aakash3141/ieeewhackaclanker/IEEEArcade/Project Information/Scoreboard Display/FrontofDisplay.png

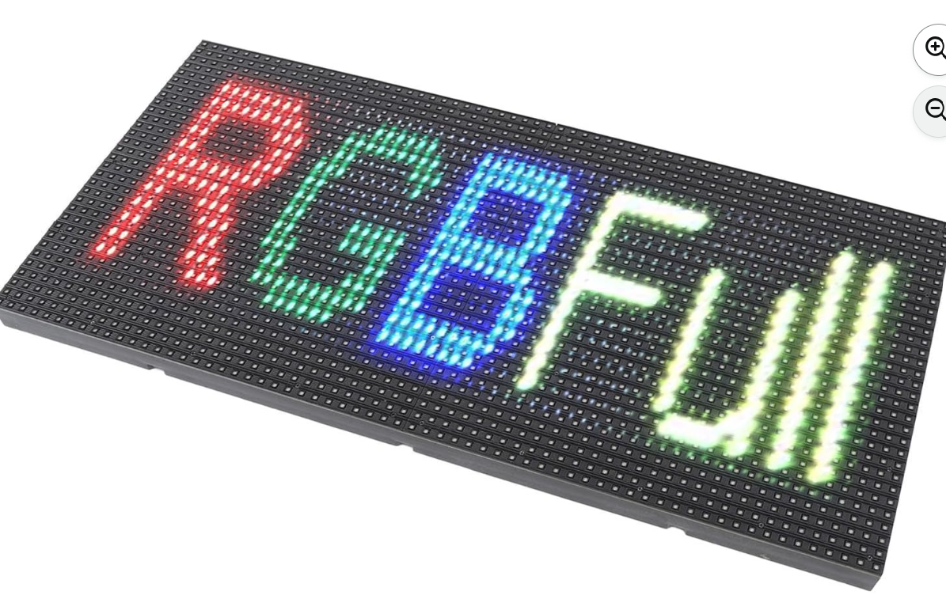
IEEEArcade/Project Information/Scoreboard Display/FrontofDisplay.png
