aakash3141/ieeewhackaclanker/IEEEArcade/Project Information/Scoreboard Display/BackofDisplay.png

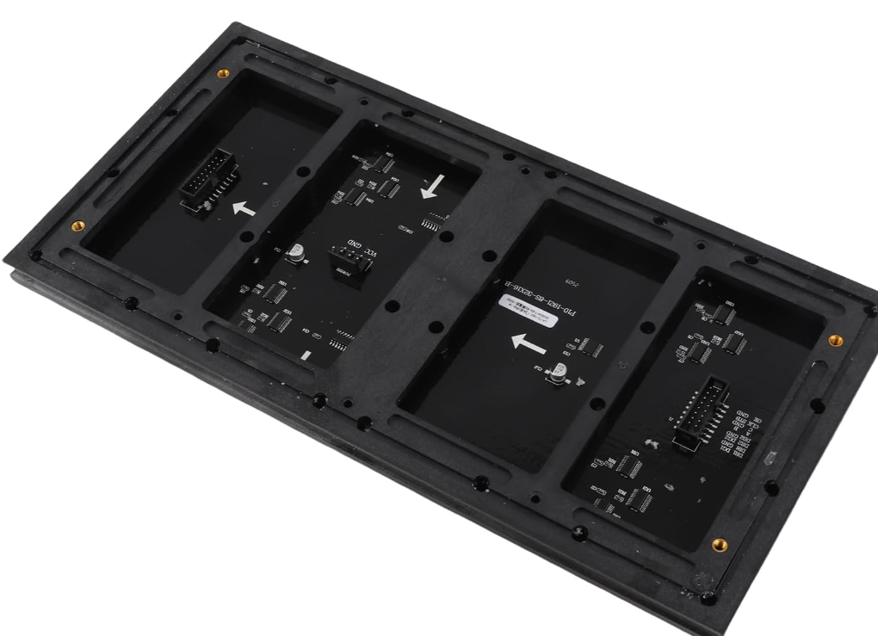
IEEEArcade/Project Information/Scoreboard Display/BackofDisplay.png
