aakash3141/ieeewhackaclanker/IEEEArcade/Project Information/Scoreboard Display/DisplayConnections1.png

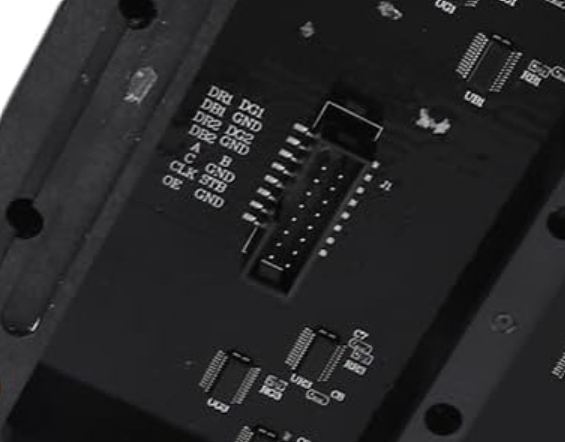
IEEEArcade/Project Information/Scoreboard Display/DisplayConnections1.png
