aakash3141/ieeewhackaclanker/IEEEArcade/Project Information/Scoreboard Display/DisplayConnections2.png

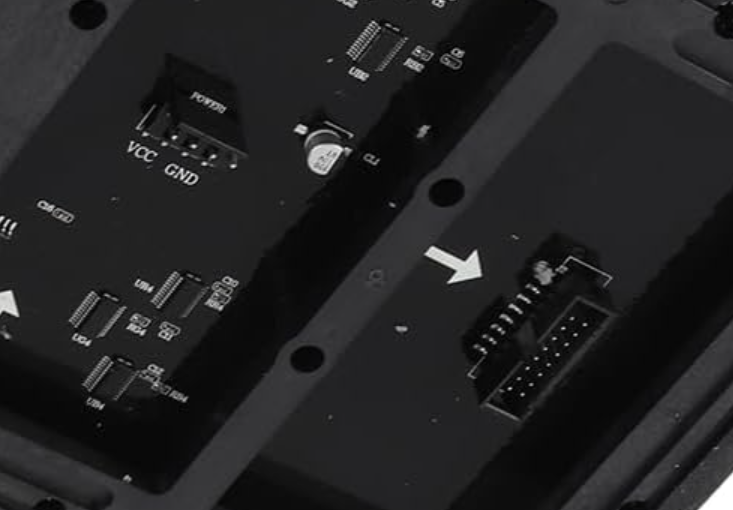
IEEEArcade/Project Information/Scoreboard Display/DisplayConnections2.png
