aakash3141/ieeewhackaclanker/IEEEArcade/BOM/26-27 Project BOM.xlsx

Bill of Materials
What we need: | Do we have it? | Part Number | Datasheet | Description | Quantity | Price
Power Converter | yes |  |  | 120VAC to 12DC 60W |  | 0
Buck Converter |  | TPS54202HDDCR | https://www.ti.com/lit/ds/symlink/tps54202h.pdf?HQS=dis-dk-null-digikeymode-dsf-pf-null-wwe&ts=1792712018270 | 12DC to 5VDC
30 Arcade Light Up Push Buttons |  |  | https://www.adafruit.com/product/1194
30 MOSFETS |  |  | https://www.aosmd.com/res/datasheets/AO3400A.pdf | Low threshold voltage, 30Vds max
Display |  |  | https://www.amazon.com/Alomejor-Scrolling-Enhanced-Lifespan-Restaurants/dp/B0G35QMCXN | P10
Small Arcade Push Buttons |  |  | https://www.amazon.com/EG-STARTS-Arcade-Buttons-Multicade/dp/B01M0XPWGG?s=toys-and-games
I/O Expander |  | MCP23017T-E/SO | https://ww1.microchip.com/downloads/aemDocuments/documents/APID/ProductDocuments/DataSheets/MCP23017-Data-Sheet-DS20001952.pdf
EEPROM |  | 24LC256-I/SN | https://ww1.microchip.com/downloads/aemDocuments/documents/MPD/ProductDocuments/DataSheets/24AA256-24LC256-24FC256-256K-I2C-Serial-EEPROM-DS20001203.pdf
Wire
