aakash3141/ieeewhackaclanker/IEEEArcade/IEEEArcade.kicad_pcb

## KiCad design IEEEArcade/IEEEArcade.kicad_pcb (2026-11-10)

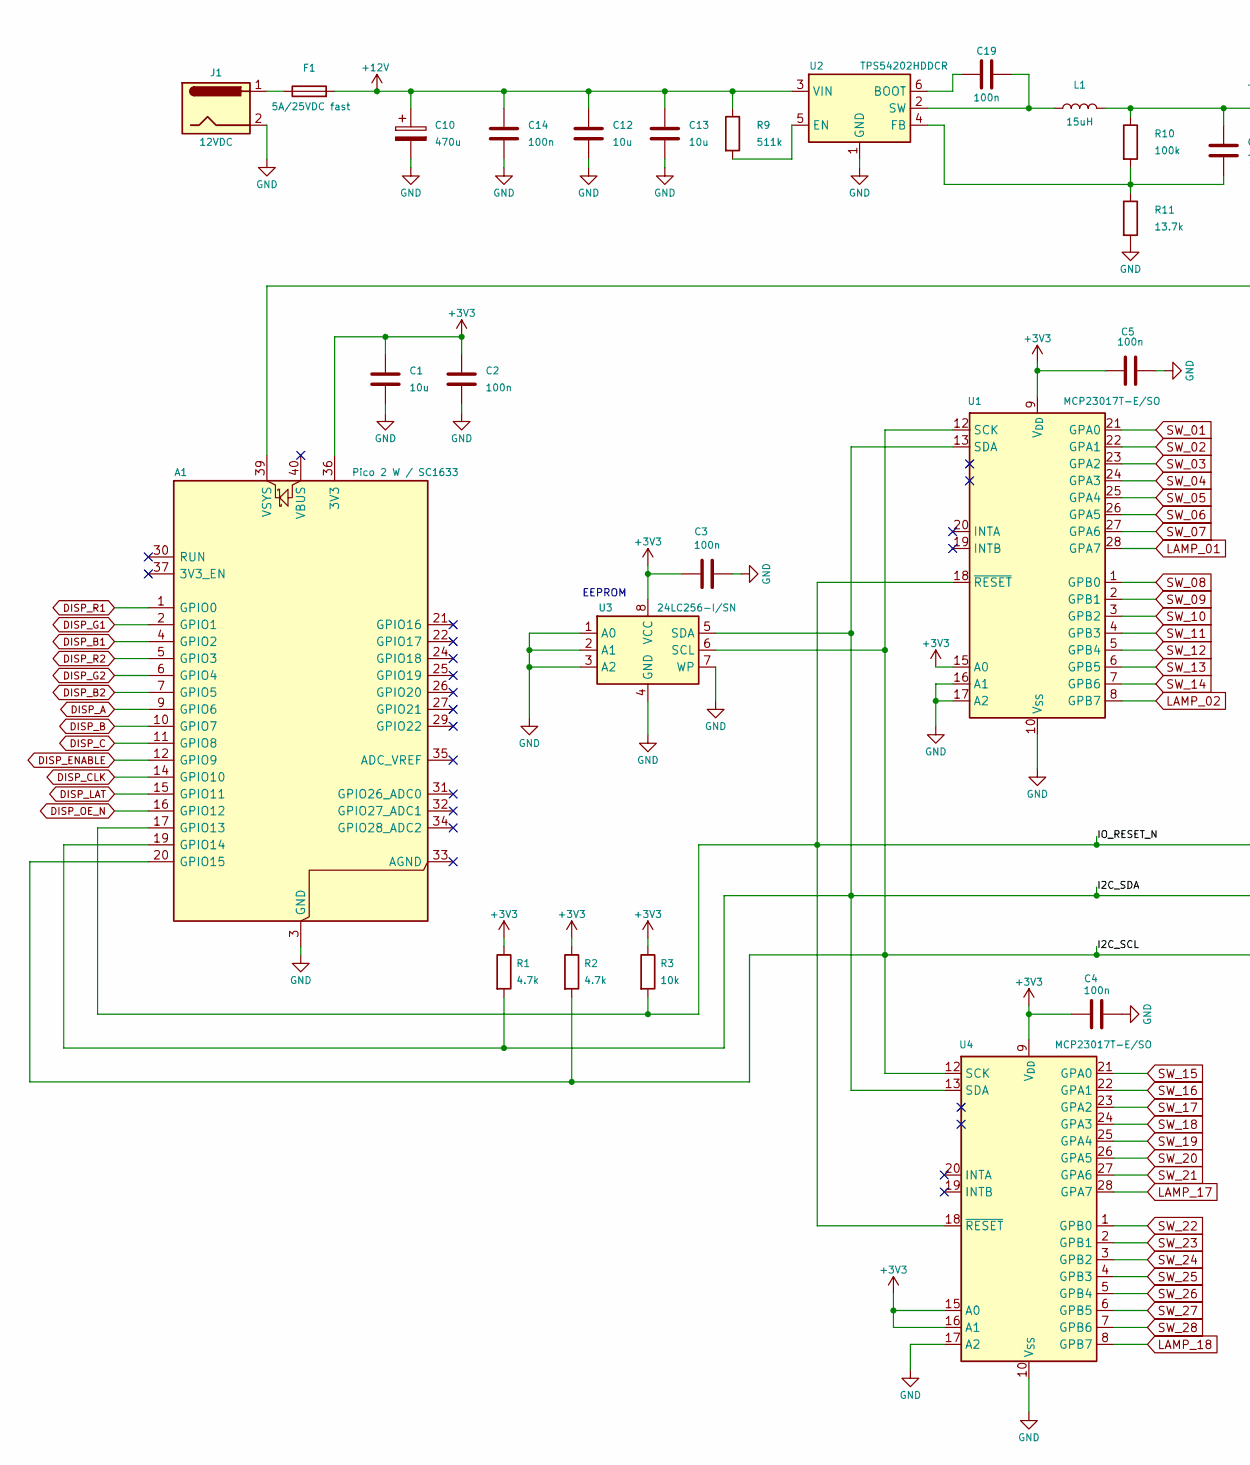
[picture p7: schematic IEEEArcade.kicad_sch, IEEE Arcade, part in row 1, column 1]

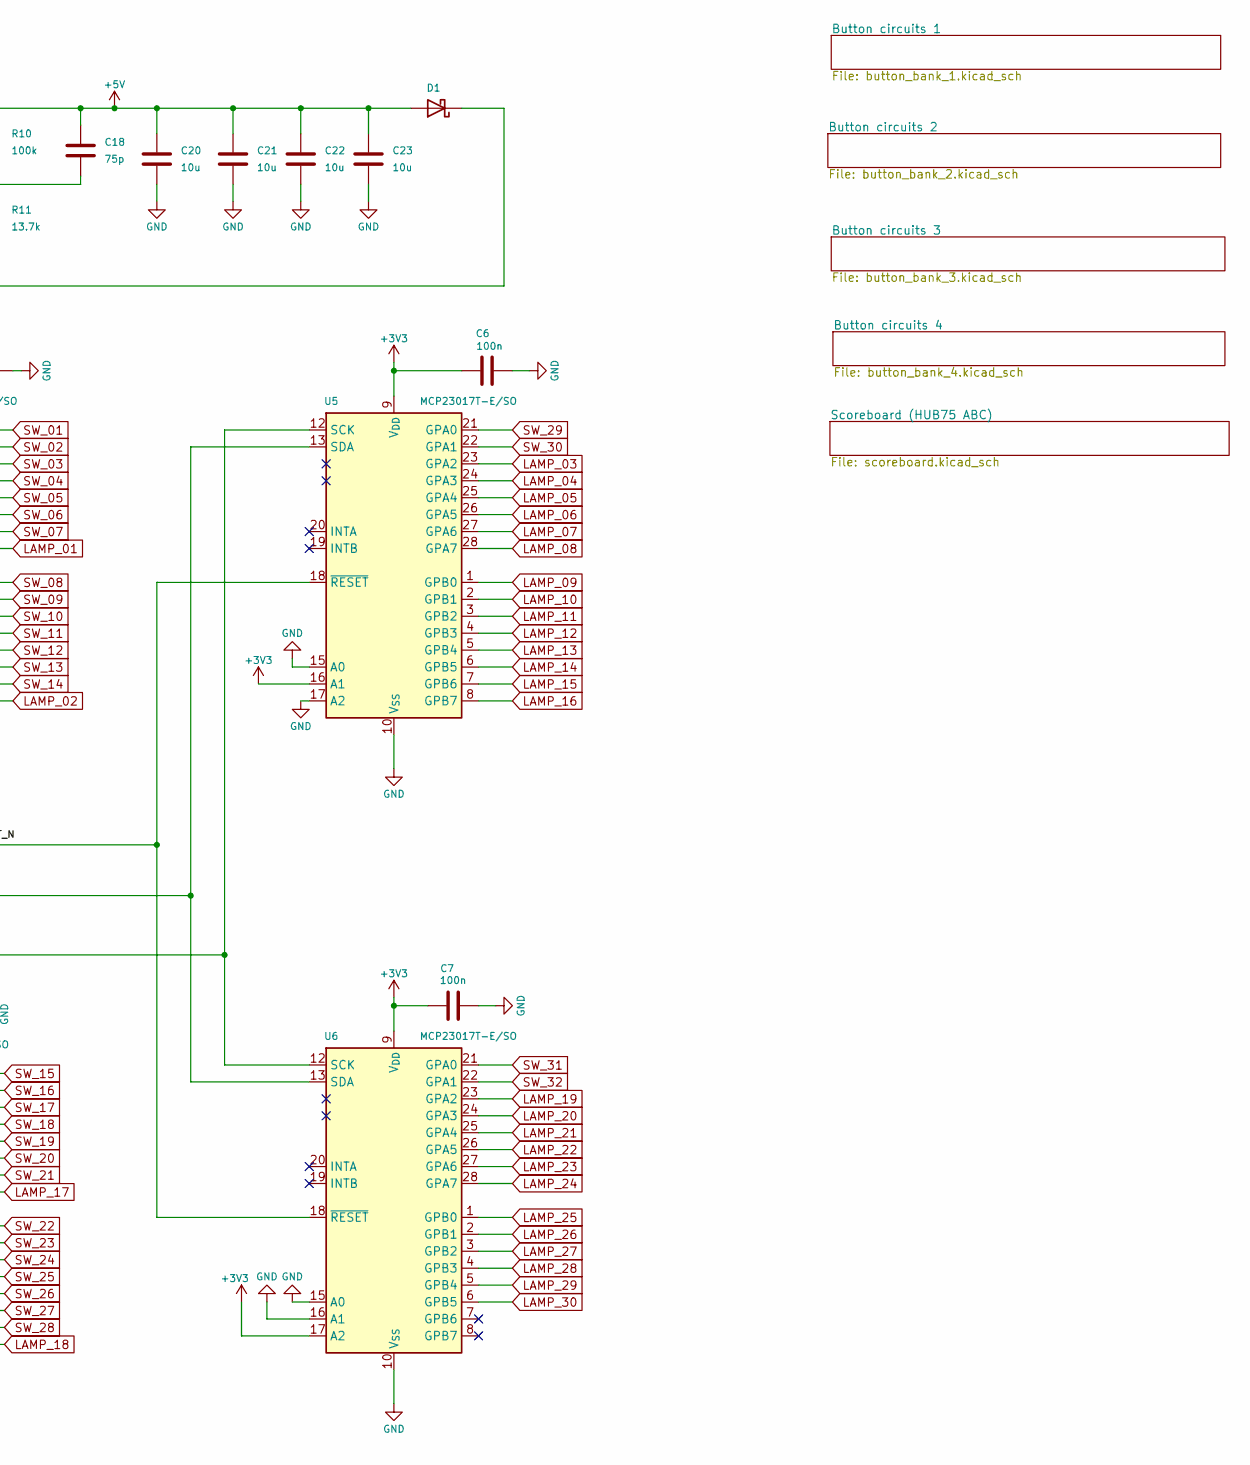
[picture p8: schematic IEEEArcade.kicad_sch, IEEE Arcade, part in row 1, column 2]

Parts:
A1: Pico 2 W / SC1633; RaspberryPi_Pico_W_SMD_HandSolder; MPN SC1633; DigiKey 2648-SC1633CT-ND
C1, C12, C13, C20, C21, C22, C23: 10u; C_1206_3216Metric_Pad1.33x1.80mm_HandSolder; MPN C1206C106K3RACTU; DigiKey 399-C1206C106K3RACTUCT-ND
C2, C3, C4, C5, C6, C7, C14, C19: 100n; C_1206_3216Metric_Pad1.33x1.80mm_HandSolder; MPN C1206C104K5RACTU; DigiKey 399-C1206C104K5RACTUCT-ND
C10: 470u; CP_Radial_D10.0mm_P5.00mm; MPN EEU-FR1E471; DigiKey P14419-ND
C18: 75p; C_1206_3216Metric_Pad1.33x1.80mm_HandSolder; MPN C1206C750J5GACTU; DigiKey 399-14710-1-ND
D1: SS14 / VSYS OR-ing; D_SMA; MPN SS14-E3/61T; DigiKey SS14-E3/61TGICT-ND
F1: 5A/25VDC fast; Fuseholder_Littelfuse_Nano2_154x; MPN 0154005.DR; DigiKey F1228CT-ND
J1: 12VDC; BarrelJack_CUI_PJ-063AH_Horizontal; MPN PJ-063AH; DigiKey CP-063AH-ND
L1: 15uH; L_Wurth_7447714150; MPN 7447714150; DigiKey 732-2990-1-ND
R1, R2: 4.7k; R_1206_3216Metric_Pad1.30x1.75mm_HandSolder; MPN RC1206FR-074K7L; DigiKey 311-4.70KFRCT-ND
R3: 10k; R_1206_3216Metric_Pad1.30x1.75mm_HandSolder; MPN RC1206FR-0710KL; DigiKey 311-10.0KFRCT-ND
R9: 511k; R_1206_3216Metric_Pad1.30x1.75mm_HandSolder; MPN RC1206FR-07511KL; DigiKey 311-511KFRCT-ND
R10: 100k; R_1206_3216Metric_Pad1.30x1.75mm_HandSolder; MPN RC1206FR-07100KL; DigiKey 311-100KFRCT-ND
R11: 13.7k; R_1206_3216Metric_Pad1.30x1.75mm_HandSolder; MPN RC1206FR-0713K7L; DigiKey 311-13.7KFRCT-ND
U1, U4, U5, U6: MCP23017T-E/SO; SOIC-28W_7.5x17.9mm_P1.27mm; MPN MCP23017T-E/SO; DigiKey MCP23017T-E/SOCT-ND
U2: TPS54202HDDCR; SOT-23-6_Handsoldering; MPN TPS54202HDDCR; DigiKey 296-44396-1-ND
U3: 24LC256-I/SN; SOIC-8_3.9x4.9mm_P1.27mm; MPN 24LC256-I/SN; DigiKey 24LC256-I/SN-ND

Connections:
+3V3: A1.36 (3V3), C1.1, C2.1, C3.1, C4.1, C5.1, C6.1, C7.1, R1.1, R2.1, R3.1, U1.9 (V_{DD}), U1.15 (A0), U3.8 (VCC), U4.9 (V_{DD}), U4.15 (A0), U4.16 (A1), U5.9 (V_{DD}), U5.16 (A1), U6.9 (V_{DD}), U6.17 (A2); also elsewhere on the board
+5V: C18.1, C20.1, C21.1, C22.1, C23.1, D1.2 (A), L1.2, R10.1
+12V: C10.1, C12.1, C13.1, C14.1, F1.2, R9.1, U2.3 (VIN); also elsewhere on the board
/I2C_SCL: A1.20 (GPIO15), R2.2, U1.12 (SCK), U3.6 (SCL), U4.12 (SCK), U5.12 (SCK), U6.12 (SCK)
/I2C_SDA: A1.19 (GPIO14), R1.2, U1.13 (SDA), U3.5 (SDA), U4.13 (SDA), U5.13 (SDA), U6.13 (SDA)
/IO_RESET_N: A1.17 (GPIO13), R3.2, U1.18 (~RESET), U4.18 (~RESET), U5.18 (~RESET), U6.18 (~RESET)
DISP_A: A1.9 (GPIO6); also elsewhere on the board
DISP_B: A1.10 (GPIO7); also elsewhere on the board
DISP_B1: A1.4 (GPIO2); also elsewhere on the board
DISP_B2: A1.7 (GPIO5); also elsewhere on the board
DISP_C: A1.11 (GPIO8); also elsewhere on the board
DISP_CLK: A1.14 (GPIO10); also elsewhere on the board
DISP_ENABLE: A1.12 (GPIO9); also elsewhere on the board
DISP_G1: A1.2 (GPIO1)
DISP_G2: A1.6 (GPIO4); also elsewhere on the board
DISP_LAT: A1.15 (GPIO11); also elsewhere on the board
DISP_OE_N: A1.16 (GPIO12); also elsewhere on the board
DISP_R1: A1.1 (GPIO0); also elsewhere on the board
DISP_R2: A1.5 (GPIO3); also elsewhere on the board
GND: A1.3 (GND), A1.8 (GND), A1.13 (GND), A1.18 (GND), A1.23 (GND), A1.28 (GND), A1.38 (GND), C1.2, C2.2, C3.2, C4.2, C5.2, C6.2, C7.2, C10.2, C12.2, C13.2, C14.2, C20.2, C21.2, C22.2, C23.2, J1.2, R11.2, U1.10 (V_{SS}), U1.16 (A1), U1.17 (A2), U2.1 (GND), U3.1 (A0), U3.2 (A1), U3.3 (A2), U3.4 (GND), U3.7 (WP), U4.10 (V_{SS}), U4.17 (A2), U5.10 (V_{SS}), U5.15 (A0), U5.17 (A2), U6.10 (V_{SS}), U6.15 (A0), U6.16 (A1); also elsewhere on the board
LAMP_01: U1.28 (GPA7); also elsewhere on the board
LAMP_02: U1.8 (GPB7); also elsewhere on the board
LAMP_03: U5.23 (GPA2); also elsewhere on the board
LAMP_04: U5.24 (GPA3); also elsewhere on the board
LAMP_05: U5.25 (GPA4); also elsewhere on the board
LAMP_06: U5.26 (GPA5); also elsewhere on the board
LAMP_07: U5.27 (GPA6); also elsewhere on the board
LAMP_08: U5.28 (GPA7); also elsewhere on the board
LAMP_09: U5.1 (GPB0); also elsewhere on the board
LAMP_10: U5.2 (GPB1); also elsewhere on the board
LAMP_11: U5.3 (GPB2); also elsewhere on the board
LAMP_12: U5.4 (GPB3); also elsewhere on the board
LAMP_13: U5.5 (GPB4); also elsewhere on the board
LAMP_14: U5.6 (GPB5); also elsewhere on the board
LAMP_15: U5.7 (GPB6); also elsewhere on the board
LAMP_16: U5.8 (GPB7); also elsewhere on the board
LAMP_17: U4.28 (GPA7); also elsewhere on the board
LAMP_18: U4.8 (GPB7); also elsewhere on the board
LAMP_19: U6.23 (GPA2); also elsewhere on the board
LAMP_20: U6.24 (GPA3); also elsewhere on the board
LAMP_21: U6.25 (GPA4); also elsewhere on the board
LAMP_22: U6.26 (GPA5); also elsewhere on the board
LAMP_23: U6.27 (GPA6); also elsewhere on the board
LAMP_24: U6.28 (GPA7); also elsewhere on the board
LAMP_25: U6.1 (GPB0); also elsewhere on the board
LAMP_26: U6.2 (GPB1); also elsewhere on the board
LAMP_27: U6.3 (GPB2); also elsewhere on the board
LAMP_28: U6.4 (GPB3); also elsewhere on the board
LAMP_29: U6.5 (GPB4); also elsewhere on the board
LAMP_30: U6.6 (GPB5); also elsewhere on the board
unnamed: A1.39 (VSYS), D1.1 (K)
unnamed: F1.1, J1.1
unnamed: C19.1, U2.6 (BOOT)
unnamed: R9.2, U2.5 (EN)
unnamed: C18.2, R10.2, R11.1, U2.4 (FB)
unnamed: C19.2, L1.1, U2.2 (SW)
SW_01: U1.21 (GPA0); also elsewhere on the board
SW_02: U1.22 (GPA1); also elsewhere on the board
SW_03: U1.23 (GPA2); also elsewhere on the board
SW_04: U1.24 (GPA3); also elsewhere on the board
SW_05: U1.25 (GPA4); also elsewhere on the board
SW_06: U1.26 (GPA5); also elsewhere on the board
SW_07: U1.27 (GPA6); also elsewhere on the board
SW_08: U1.1 (GPB0); also elsewhere on the board
SW_09: U1.2 (GPB1); also elsewhere on the board
SW_10: U1.3 (GPB2); also elsewhere on the board
SW_11: U1.4 (GPB3); also elsewhere on the board
SW_12: U1.5 (GPB4); also elsewhere on the board
SW_13: U1.6 (GPB5); also elsewhere on the board
SW_14: U1.7 (GPB6); also elsewhere on the board
SW_15: U4.21 (GPA0); also elsewhere on the board
SW_16: U4.22 (GPA1); also elsewhere on the board
SW_17: U4.23 (GPA2); also elsewhere on the board
SW_18: U4.24 (GPA3); also elsewhere on the board
SW_19: U4.25 (GPA4); also elsewhere on the board
SW_20: U4.26 (GPA5); also elsewhere on the board
SW_21: U4.27 (GPA6); also elsewhere on the board
SW_22: U4.1 (GPB0); also elsewhere on the board
SW_23: U4.2 (GPB1); also elsewhere on the board
SW_24: U4.3 (GPB2); also elsewhere on the board
SW_25: U4.4 (GPB3); also elsewhere on the board
SW_26: U4.5 (GPB4); also elsewhere on the board
SW_27: U4.6 (GPB5); also elsewhere on the board
SW_28: U4.7 (GPB6); also elsewhere on the board
SW_29: U5.21 (GPA0); also elsewhere on the board
SW_30: U5.22 (GPA1); also elsewhere on the board
SW_31: U6.21 (GPA0); also elsewhere on the board
SW_32: U6.22 (GPA1); also elsewhere on the board

Notes on the sheet:
EEPROM

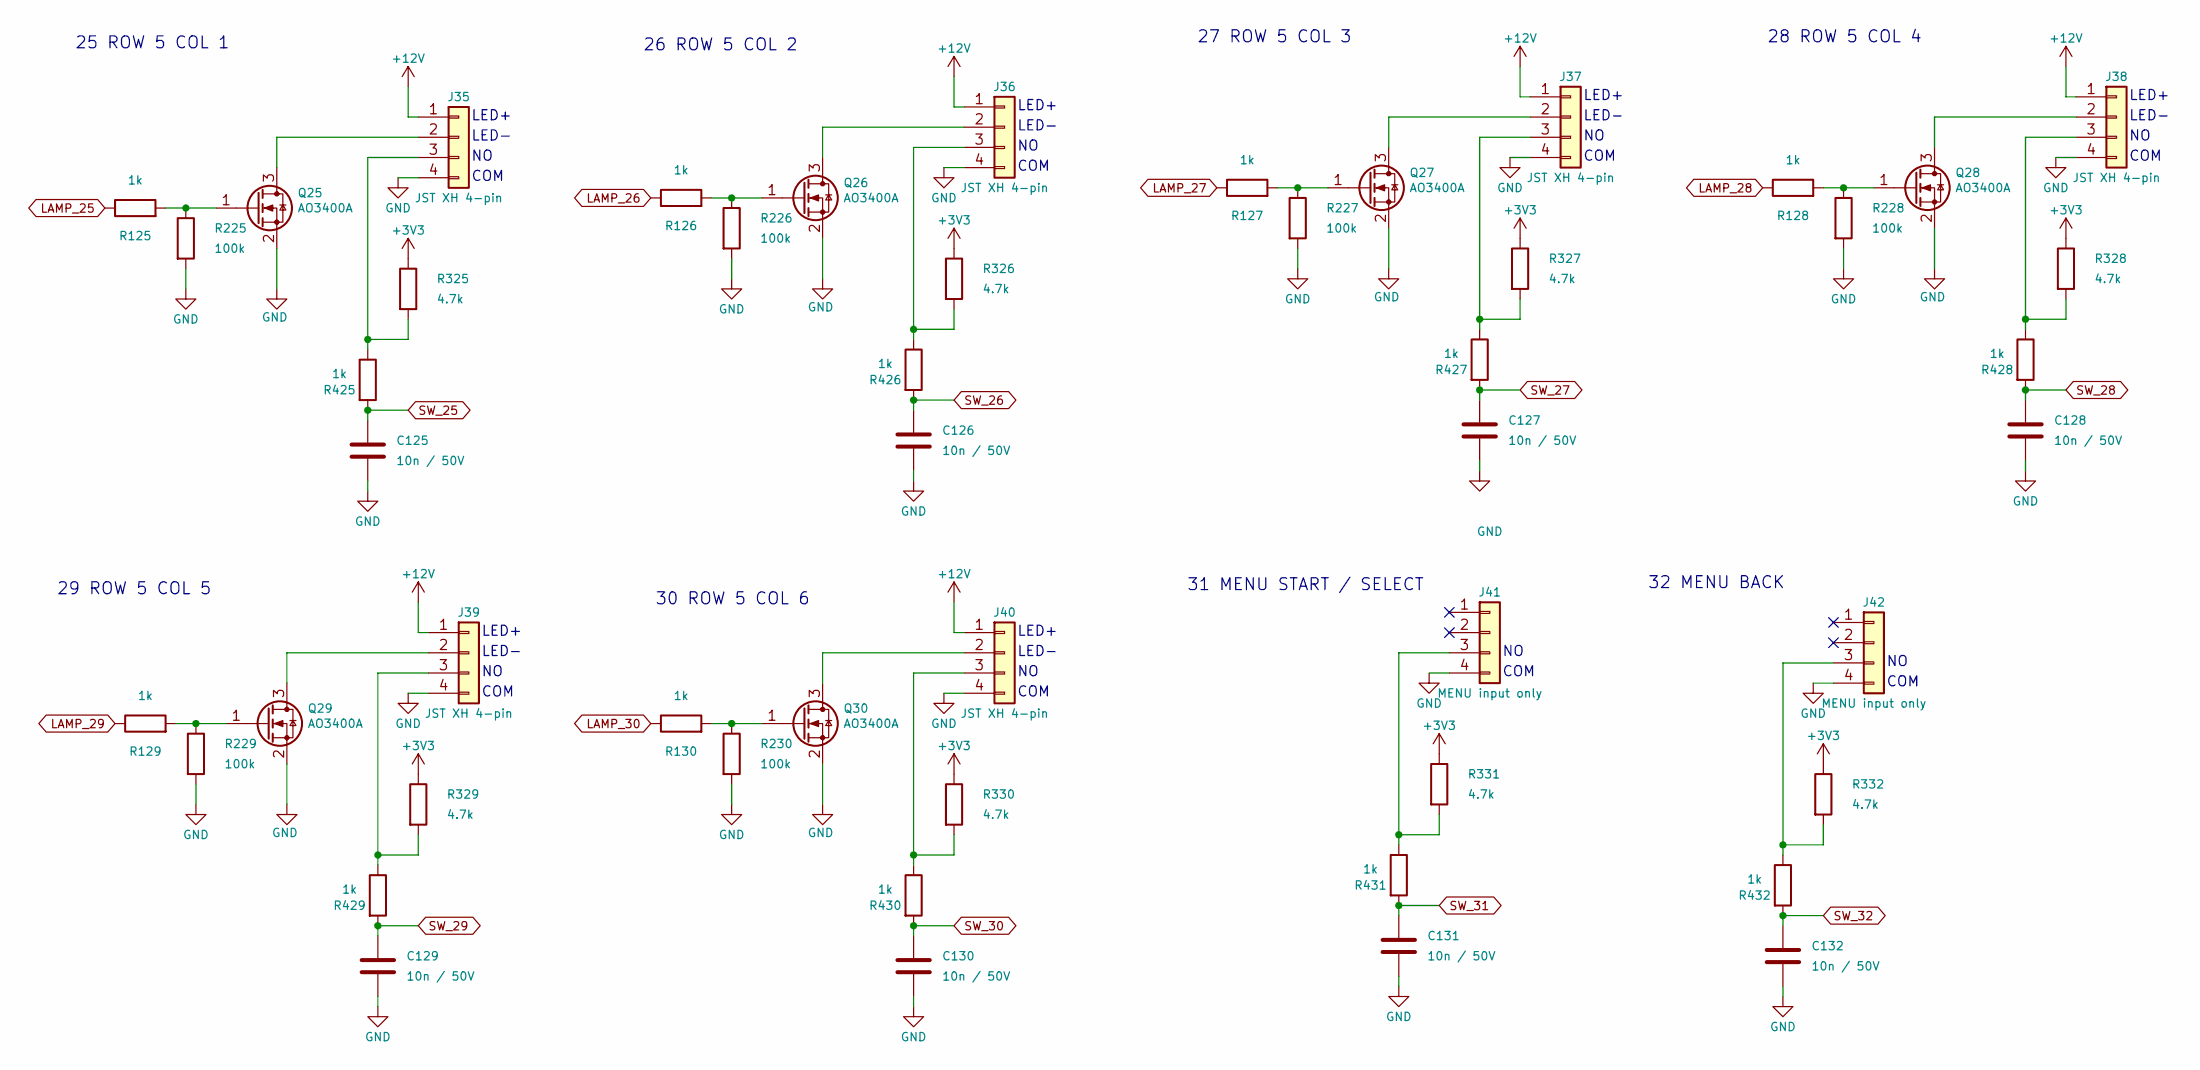
[picture p9: schematic button_bank_4.kicad_sch, Button harness: Buttons 25-32]

Parts:
C125, C126, C127, C128, C129, C130, C131, C132: 10n / 50V; C_1206_3216Metric_Pad1.33x1.80mm_HandSolder; MPN C1206C103K5RACTU; DigiKey 399-C1206C103K5RACTUCT-ND
J35, J36, J37, J38, J39, J40: JST XH 4-pin; JST_XH_B4B-XH-A_1x04_P2.50mm_Vertical; MPN B4B-XH-A; DigiKey 455-B4B-XH-A-ND
J41, J42: MENU input only; JST_XH_B4B-XH-A_1x04_P2.50mm_Vertical; MPN B4B-XH-A; DigiKey 455-B4B-XH-A-ND
Q25, Q26, Q27, Q28, Q29, Q30: AO3400A; SOT-23; MPN AO3400A; DigiKey 785-1000-1-ND
R125, R126, R127, R128, R129, R130, R425, R426, R427, R428, R429, R430, R431, R432: 1k; R_1206_3216Metric_Pad1.30x1.75mm_HandSolder; MPN RC1206FR-071KL; DigiKey 311-1.00KFRCT-ND
R225, R226, R227, R228, R229, R230: 100k; R_1206_3216Metric_Pad1.30x1.75mm_HandSolder; MPN RC1206FR-07100KL; DigiKey 311-100KFRCT-ND
R325, R326, R327, R328, R329, R330, R331, R332: 4.7k; R_1206_3216Metric_Pad1.30x1.75mm_HandSolder; MPN RC1206FR-074K7L; DigiKey 311-4.70KFRCT-ND

Connections:
+3V3: R325.1, R326.1, R327.1, R328.1, R329.1, R330.1, R331.1, R332.1; also elsewhere on the board
+12V: J35.1, J36.1, J37.1, J38.1, J39.1, J40.1; also elsewhere on the board
GND: C125.2, C126.2, C127.2, C128.2, C129.2, C130.2, C131.2, C132.2, J35.4, J36.4, J37.4, J38.4, J39.4, J40.4, J41.4, J42.4, Q25.2 (S), Q26.2 (S), Q27.2 (S), Q28.2 (S), Q29.2 (S), Q30.2 (S), R225.2, R226.2, R227.2, R228.2, R229.2, R230.2; also elsewhere on the board
LAMP_25: R125.1; also elsewhere on the board
LAMP_26: R126.1; also elsewhere on the board
LAMP_27: R127.1; also elsewhere on the board
LAMP_28: R128.1; also elsewhere on the board
LAMP_29: R129.1; also elsewhere on the board
LAMP_30: R130.1; also elsewhere on the board
unnamed: J35.2, Q25.3 (D)
unnamed: J35.3, R325.2, R425.1
unnamed: J36.2, Q26.3 (D)
unnamed: J36.3, R326.2, R426.1
unnamed: J37.2, Q27.3 (D)
unnamed: J37.3, R327.2, R427.1
unnamed: J38.2, Q28.3 (D)
unnamed: J38.3, R328.2, R428.1
unnamed: J39.2, Q29.3 (D)
unnamed: J39.3, R329.2, R429.1
unnamed: J40.2, Q30.3 (D)
unnamed: J40.3, R330.2, R430.1
unnamed: J41.3, R331.2, R431.1
unnamed: J42.3, R332.2, R432.1
unnamed: Q25.1 (G), R125.2, R225.1
unnamed: Q26.1 (G), R126.2, R226.1
unnamed: Q27.1 (G), R127.2, R227.1
unnamed: Q28.1 (G), R128.2, R228.1
unnamed: Q29.1 (G), R129.2, R229.1
unnamed: Q30.1 (G), R130.2, R230.1
SW_25: C125.1, R425.2; also elsewhere on the board
SW_26: C126.1, R426.2; also elsewhere on the board
SW_27: C127.1, R427.2; also elsewhere on the board
SW_28: C128.1, R428.2; also elsewhere on the board
SW_29: C129.1, R429.2; also elsewhere on the board
SW_30: C130.1, R430.2; also elsewhere on the board
SW_31: C131.1, R431.2; also elsewhere on the board
SW_32: C132.1, R432.2; also elsewhere on the board

Notes on the sheet:
COM
LED-
31 MENU START / SELECT
LED+
30 ROW 5 COL 6
29 ROW 5 COL 5
26 ROW 5 COL 2
32 MENU BACK
28 ROW 5 COL 4
25 ROW 5 COL 1
27 ROW 5 COL 3

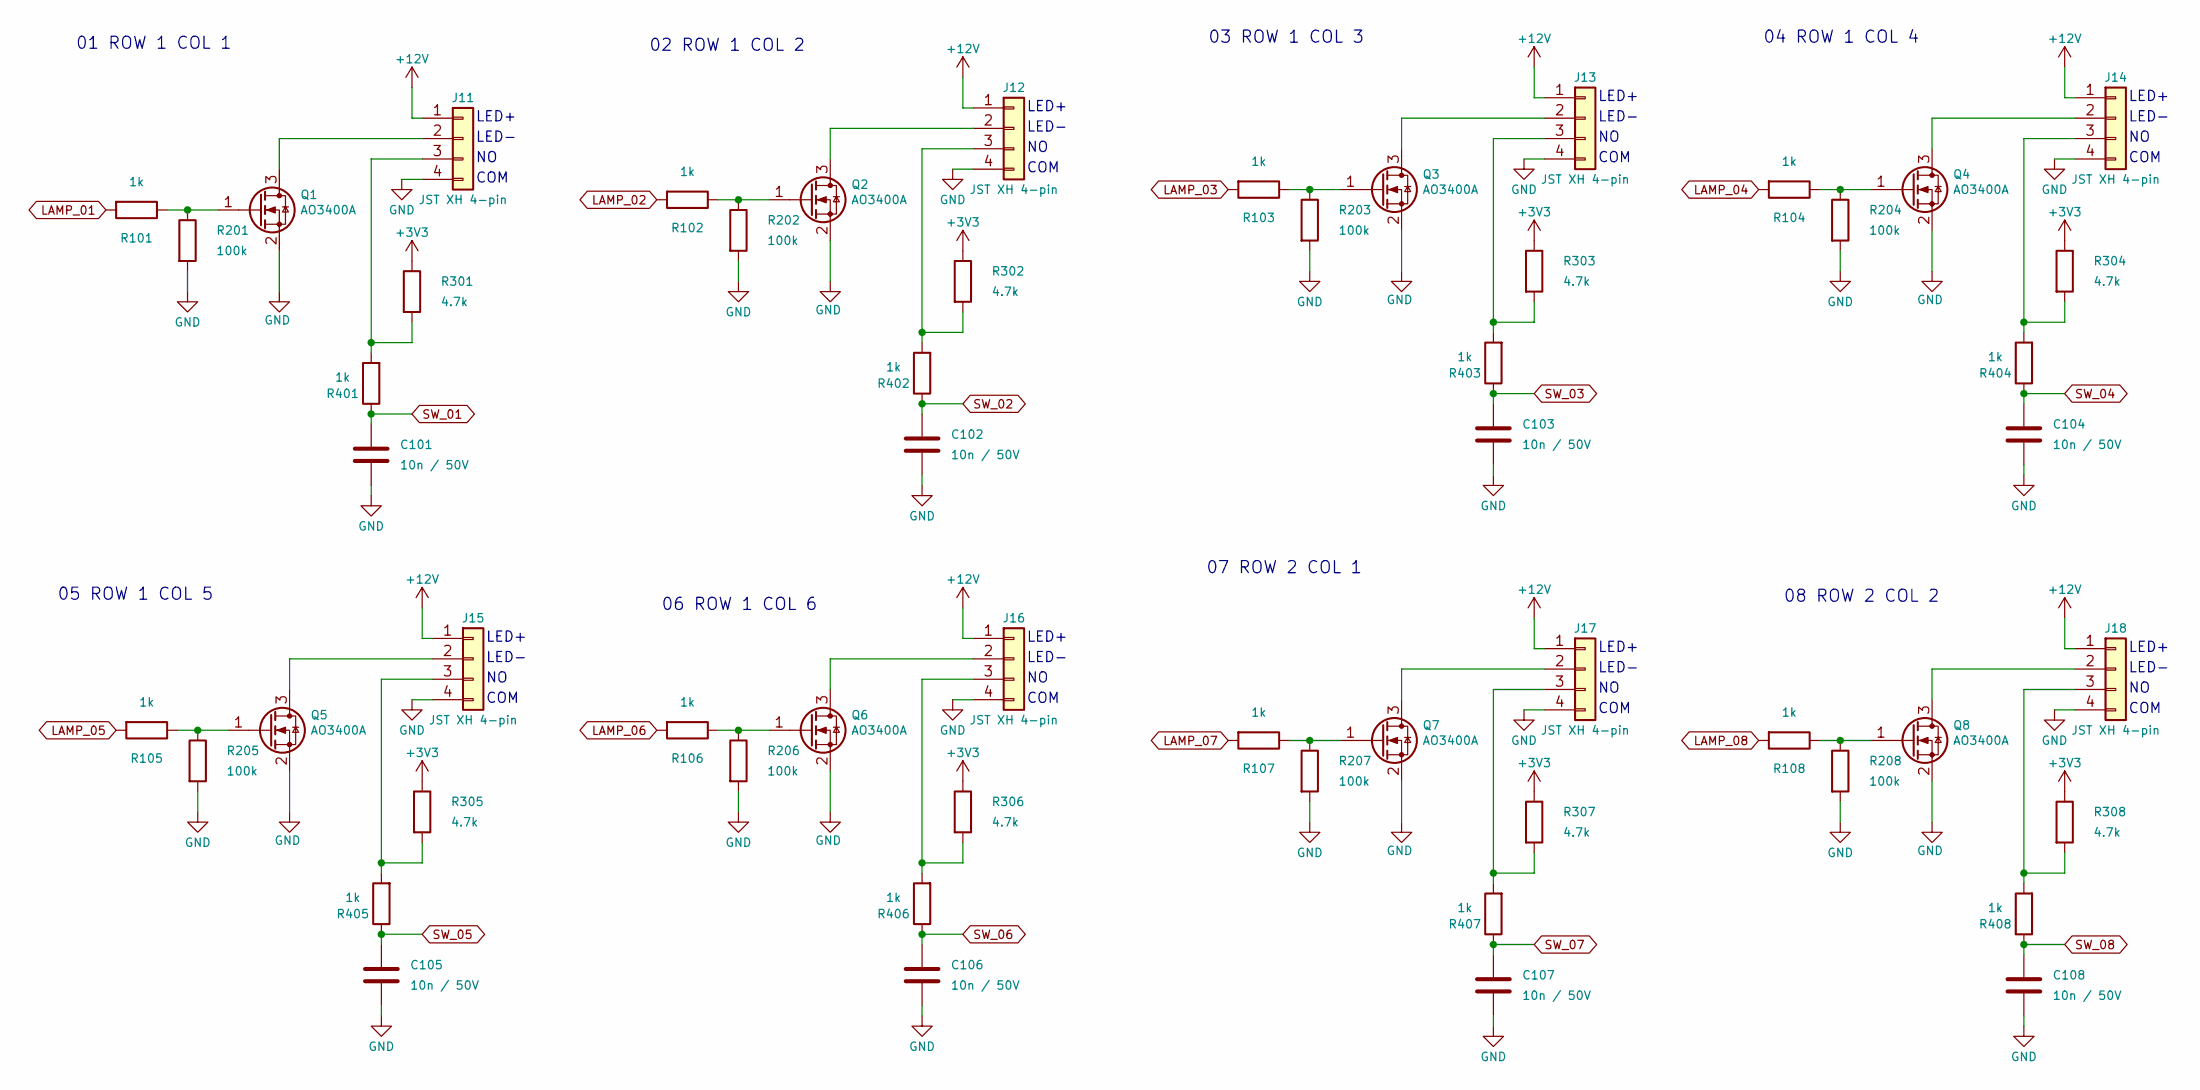
[picture p10: schematic button_bank_1.kicad_sch, Button harness: Buttons 01-08]

Parts:
C101, C102, C103, C104, C105, C106, C107, C108: 10n / 50V; C_1206_3216Metric_Pad1.33x1.80mm_HandSolder; MPN C1206C103K5RACTU; DigiKey 399-C1206C103K5RACTUCT-ND
J11, J12, J13, J14, J15, J16, J17, J18: JST XH 4-pin; JST_XH_B4B-XH-A_1x04_P2.50mm_Vertical; MPN B4B-XH-A; DigiKey 455-B4B-XH-A-ND
Q1, Q2, Q3, Q4, Q5, Q6, Q7, Q8: AO3400A; SOT-23; MPN AO3400A; DigiKey 785-1000-1-ND
R101, R102, R103, R104, R105, R106, R107, R108, R401, R402, R403, R404, R405, R406, R407, R408: 1k; R_1206_3216Metric_Pad1.30x1.75mm_HandSolder; MPN RC1206FR-071KL; DigiKey 311-1.00KFRCT-ND
R201, R202, R203, R204, R205, R206, R207, R208: 100k; R_1206_3216Metric_Pad1.30x1.75mm_HandSolder; MPN RC1206FR-07100KL; DigiKey 311-100KFRCT-ND
R301, R302, R303, R304, R305, R306, R307, R308: 4.7k; R_1206_3216Metric_Pad1.30x1.75mm_HandSolder; MPN RC1206FR-074K7L; DigiKey 311-4.70KFRCT-ND

Connections:
+3V3: R301.1, R302.1, R303.1, R304.1, R305.1, R306.1, R307.1, R308.1; also elsewhere on the board
+12V: J11.1, J12.1, J13.1, J14.1, J15.1, J16.1, J17.1, J18.1; also elsewhere on the board
GND: C101.2, C102.2, C103.2, C104.2, C105.2, C106.2, C107.2, C108.2, J11.4, J12.4, J13.4, J14.4, J15.4, J16.4, J17.4, J18.4, Q1.2 (S), Q2.2 (S), Q3.2 (S), Q4.2 (S), Q5.2 (S), Q6.2 (S), Q7.2 (S), Q8.2 (S), R201.2, R202.2, R203.2, R204.2, R205.2, R206.2, R207.2, R208.2; also elsewhere on the board
LAMP_01: R101.2; also elsewhere on the board
LAMP_02: R102.2; also elsewhere on the board
LAMP_03: R103.2; also elsewhere on the board
LAMP_04: R104.2; also elsewhere on the board
LAMP_05: R105.2; also elsewhere on the board
LAMP_06: R106.2; also elsewhere on the board
LAMP_07: R107.2; also elsewhere on the board
LAMP_08: R108.2; also elsewhere on the board
unnamed: J11.2, Q1.3 (D)
unnamed: J11.3, R301.2, R401.2
unnamed: J12.2, Q2.3 (D)
unnamed: J12.3, R302.2, R402.2
unnamed: J13.2, Q3.3 (D)
unnamed: J13.3, R303.2, R403.2
unnamed: J14.2, Q4.3 (D)
unnamed: J14.3, R304.2, R404.2
unnamed: J15.2, Q5.3 (D)
unnamed: J15.3, R305.2, R405.2
unnamed: J16.2, Q6.3 (D)
unnamed: J16.3, R306.2, R406.2
unnamed: J17.2, Q7.3 (D)
unnamed: J17.3, R307.2, R407.2
unnamed: J18.2, Q8.3 (D)
unnamed: J18.3, R308.2, R408.2
unnamed: Q1.1 (G), R101.1, R201.1
unnamed: Q2.1 (G), R102.1, R202.1
unnamed: Q3.1 (G), R103.1, R203.1
unnamed: Q4.1 (G), R104.1, R204.1
unnamed: Q5.1 (G), R105.1, R205.1
unnamed: Q6.1 (G), R106.1, R206.1
unnamed: Q7.1 (G), R107.1, R207.1
unnamed: Q8.1 (G), R108.1, R208.1
SW_01: C101.1, R401.1; also elsewhere on the board
SW_02: C102.1, R402.1; also elsewhere on the board
SW_03: C103.1, R403.1; also elsewhere on the board
SW_04: C104.1, R404.1; also elsewhere on the board
SW_05: C105.1, R405.1; also elsewhere on the board
SW_06: C106.1, R406.1; also elsewhere on the board
SW_07: C107.1, R407.1; also elsewhere on the board
SW_08: C108.1, R408.1; also elsewhere on the board

Notes on the sheet:
LED+
LED-
05 ROW 1 COL 5
COM
04 ROW 1 COL 4
03 ROW 1 COL 3
01 ROW 1 COL 1
06 ROW 1 COL 6
02 ROW 1 COL 2
07 ROW 2 COL 1
08 ROW 2 COL 2

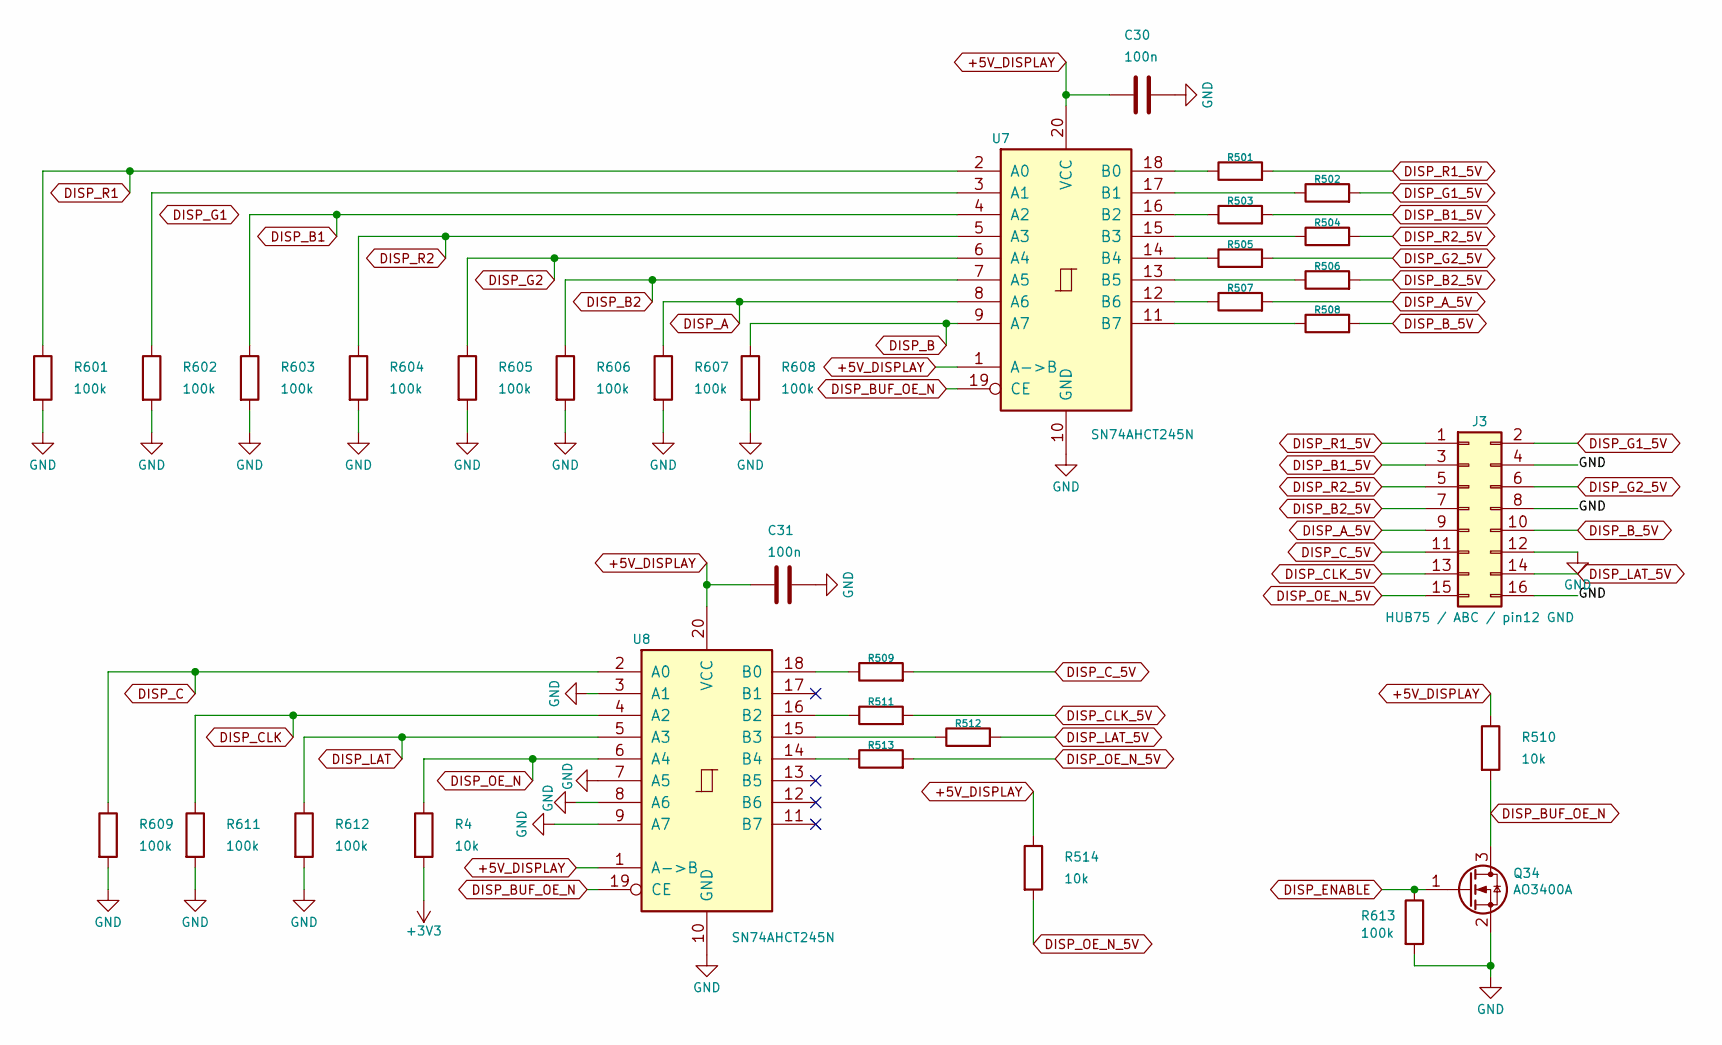
[picture p11: schematic scoreboard.kicad_sch, Photo-matched HUB75 scoreboard / A-B-C scan]

Parts:
C30, C31: 100n; C_1206_3216Metric_Pad1.33x1.80mm_HandSolder; MPN C1206C104K5RACTU; DigiKey 399-C1206C104K5RACTUCT-ND
J3: HUB75 / ABC / pin12 GND; IDC_3M_N2516_2x08; MPN N2516-6002-RB; DigiKey MHC16K-ND
Q34: AO3400A; SOT-23; MPN AO3400A; DigiKey 785-1000-1-ND
R4, R510, R514: 10k; R_1206_3216Metric_Pad1.30x1.75mm_HandSolder; MPN RC1206FR-0710KL; DigiKey 311-10.0KFRCT-ND
R501, R502, R503, R504, R505, R506, R507, R508, R509, R511, R512, R513: 33; R_1206_3216Metric_Pad1.30x1.75mm_HandSolder; MPN RC1206FR-0733RL; DigiKey 311-33.0FRCT-ND
R601, R602, R603, R604, R605, R606, R607, R608, R609, R611, R612, R613: 100k; R_1206_3216Metric_Pad1.30x1.75mm_HandSolder; MPN RC1206FR-07100KL; DigiKey 311-100KFRCT-ND
U7, U8: SN74AHCT245N; DIP-20_W7.62mm; MPN SN74AHCT245N; DigiKey 296-1476-5-ND

Connections:
+3V3: R4.2; also elsewhere on the board
+5V_DISPLAY: C30.1, C31.1, R510.1, R514.1, U7.1 (A->B), U7.20 (VCC), U8.1 (A->B), U8.20 (VCC)
DISP_A: R607.1, U7.8 (A6); also elsewhere on the board
DISP_A_5V: J3.9, R507.2
DISP_B: R608.1, U7.9 (A7); also elsewhere on the board
DISP_B1: R603.1, U7.4 (A2); also elsewhere on the board
DISP_B1_5V: J3.3, R503.2
DISP_B2: R606.1, U7.7 (A5); also elsewhere on the board
DISP_B2_5V: J3.7, R506.2
DISP_BUF_OE_N: Q34.3 (D), R510.2, U7.19 (CE), U8.19 (CE)
DISP_B_5V: J3.10, R508.2
DISP_C: R609.1, U8.2 (A0); also elsewhere on the board
DISP_CLK: R611.1, U8.4 (A2); also elsewhere on the board
DISP_CLK_5V: J3.13, R511.2
DISP_C_5V: J3.11, R509.2
DISP_ENABLE: Q34.1 (G), R613.1; also elsewhere on the board
DISP_G1_5V: J3.2, R502.2
DISP_G2: R605.1, U7.6 (A4); also elsewhere on the board
DISP_G2_5V: J3.6, R505.2
DISP_LAT: R612.1, U8.5 (A3); also elsewhere on the board
DISP_LAT_5V: J3.14, R512.2
DISP_OE_N: R4.1, U8.6 (A4); also elsewhere on the board
DISP_OE_N_5V: J3.15, R513.2, R514.2
DISP_R1: R601.1, U7.2 (A0); also elsewhere on the board
DISP_R1_5V: J3.1, R501.2
DISP_R2: R604.1, U7.5 (A3); also elsewhere on the board
DISP_R2_5V: J3.5, R504.2
GND: C30.2, C31.2, J3.4, J3.8, J3.12, J3.16, Q34.2 (S), R601.2, R602.2, R603.2, R604.2, R605.2, R606.2, R607.2, R608.2, R609.2, R611.2, R612.2, R613.2, U7.10 (GND), U8.3 (A1), U8.7 (A5), U8.8 (A6), U8.9 (A7), U8.10 (GND); also elsewhere on the board
unnamed: R602.1, U7.3 (A1)
unnamed: R501.1, U7.18 (B0)
unnamed: R502.1, U7.17 (B1)
unnamed: R503.1, U7.16 (B2)
unnamed: R504.1, U7.15 (B3)
unnamed: R505.1, U7.14 (B4)
unnamed: R506.1, U7.13 (B5)
unnamed: R507.1, U7.12 (B6)
unnamed: R508.1, U7.11 (B7)
unnamed: R509.1, U8.18 (B0)
unnamed: R511.1, U8.16 (B2)
unnamed: R512.1, U8.15 (B3)
unnamed: R513.1, U8.14 (B4)
