aakash3141/ieeewhackaclanker/IEEEArcade/IEEEArcade.kicad_pcb

## KiCad design IEEEArcade/IEEEArcade.kicad_pcb (continued)

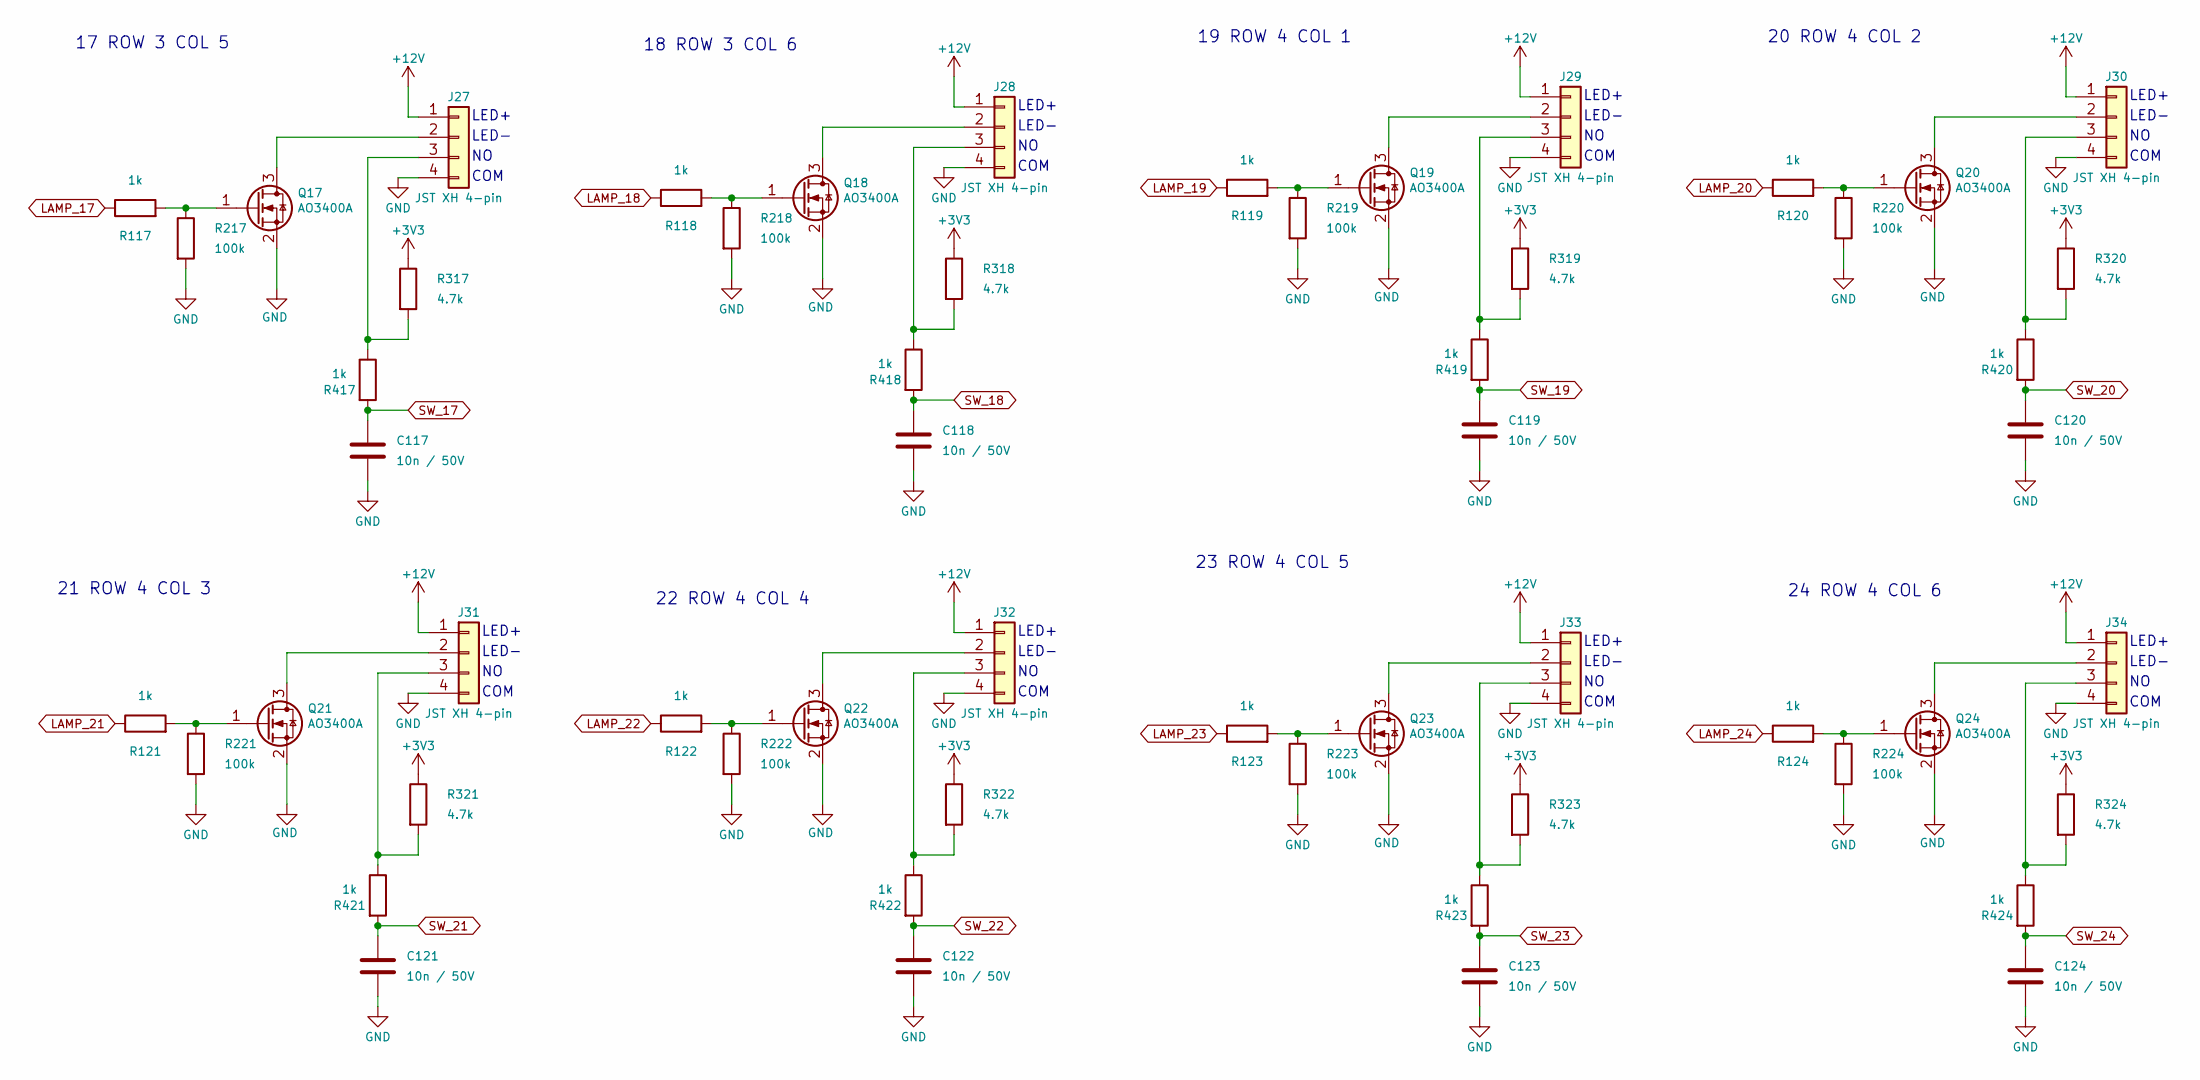
[picture p12: schematic button_bank_3.kicad_sch, Button harness: Buttons 17-24]

Parts:
C117, C118, C119, C120, C121, C122, C123, C124: 10n / 50V; C_1206_3216Metric_Pad1.33x1.80mm_HandSolder; MPN C1206C103K5RACTU; DigiKey 399-C1206C103K5RACTUCT-ND
J27, J28, J29, J30, J31, J32, J33, J34: JST XH 4-pin; JST_XH_B4B-XH-A_1x04_P2.50mm_Vertical; MPN B4B-XH-A; DigiKey 455-B4B-XH-A-ND
Q17, Q18, Q19, Q20, Q21, Q22, Q23, Q24: AO3400A; SOT-23; MPN AO3400A; DigiKey 785-1000-1-ND
R117, R118, R119, R120, R121, R122, R123, R124, R417, R418, R419, R420, R421, R422, R423, R424: 1k; R_1206_3216Metric_Pad1.30x1.75mm_HandSolder; MPN RC1206FR-071KL; DigiKey 311-1.00KFRCT-ND
R217, R218, R219, R220, R221, R222, R223, R224: 100k; R_1206_3216Metric_Pad1.30x1.75mm_HandSolder; MPN RC1206FR-07100KL; DigiKey 311-100KFRCT-ND
R317, R318, R319, R320, R321, R322, R323, R324: 4.7k; R_1206_3216Metric_Pad1.30x1.75mm_HandSolder; MPN RC1206FR-074K7L; DigiKey 311-4.70KFRCT-ND

Connections:
+3V3: R317.1, R318.1, R319.1, R320.1, R321.1, R322.1, R323.1, R324.1; also elsewhere on the board
+12V: J27.1, J28.1, J29.1, J30.1, J31.1, J32.1, J33.1, J34.1; also elsewhere on the board
GND: C117.2, C118.2, C119.2, C120.2, C121.2, C122.2, C123.2, C124.2, J27.4, J28.4, J29.4, J30.4, J31.4, J32.4, J33.4, J34.4, Q17.2 (S), Q18.2 (S), Q19.2 (S), Q20.2 (S), Q21.2 (S), Q22.2 (S), Q23.2 (S), Q24.2 (S), R217.2, R218.2, R219.2, R220.2, R221.2, R222.2, R223.2, R224.2; also elsewhere on the board
LAMP_17: R117.1; also elsewhere on the board
LAMP_18: R118.1; also elsewhere on the board
LAMP_19: R119.1; also elsewhere on the board
LAMP_20: R120.1; also elsewhere on the board
LAMP_21: R121.1; also elsewhere on the board
LAMP_22: R122.1; also elsewhere on the board
LAMP_23: R123.1; also elsewhere on the board
LAMP_24: R124.1; also elsewhere on the board
unnamed: J27.2, Q17.3 (D)
unnamed: J27.3, R317.2, R417.1
unnamed: J28.2, Q18.3 (D)
unnamed: J28.3, R318.2, R418.1
unnamed: J29.2, Q19.3 (D)
unnamed: J29.3, R319.2, R419.1
unnamed: J30.2, Q20.3 (D)
unnamed: J30.3, R320.2, R420.1
unnamed: J31.2, Q21.3 (D)
unnamed: J31.3, R321.2, R421.1
unnamed: J32.2, Q22.3 (D)
unnamed: J32.3, R322.2, R422.1
unnamed: J33.2, Q23.3 (D)
unnamed: J33.3, R323.2, R423.1
unnamed: J34.2, Q24.3 (D)
unnamed: J34.3, R324.2, R424.1
unnamed: Q17.1 (G), R117.2, R217.1
unnamed: Q18.1 (G), R118.2, R218.1
unnamed: Q19.1 (G), R119.2, R219.1
unnamed: Q20.1 (G), R120.2, R220.1
unnamed: Q21.1 (G), R121.2, R221.1
unnamed: Q22.1 (G), R122.2, R222.1
unnamed: Q23.1 (G), R123.2, R223.1
unnamed: Q24.1 (G), R124.2, R224.1
SW_17: C117.1, R417.2; also elsewhere on the board
SW_18: C118.1, R418.2; also elsewhere on the board
SW_19: C119.1, R419.2; also elsewhere on the board
SW_20: C120.1, R420.2; also elsewhere on the board
SW_21: C121.1, R421.2; also elsewhere on the board
SW_22: C122.1, R422.2; also elsewhere on the board
SW_23: C123.1, R423.2; also elsewhere on the board
SW_24: C124.1, R424.2; also elsewhere on the board

Notes on the sheet:
23 ROW 4 COL 5
LED+
LED-
COM
19 ROW 4 COL 1
20 ROW 4 COL 2
17 ROW 3 COL 5
24 ROW 4 COL 6
21 ROW 4 COL 3
18 ROW 3 COL 6
22 ROW 4 COL 4

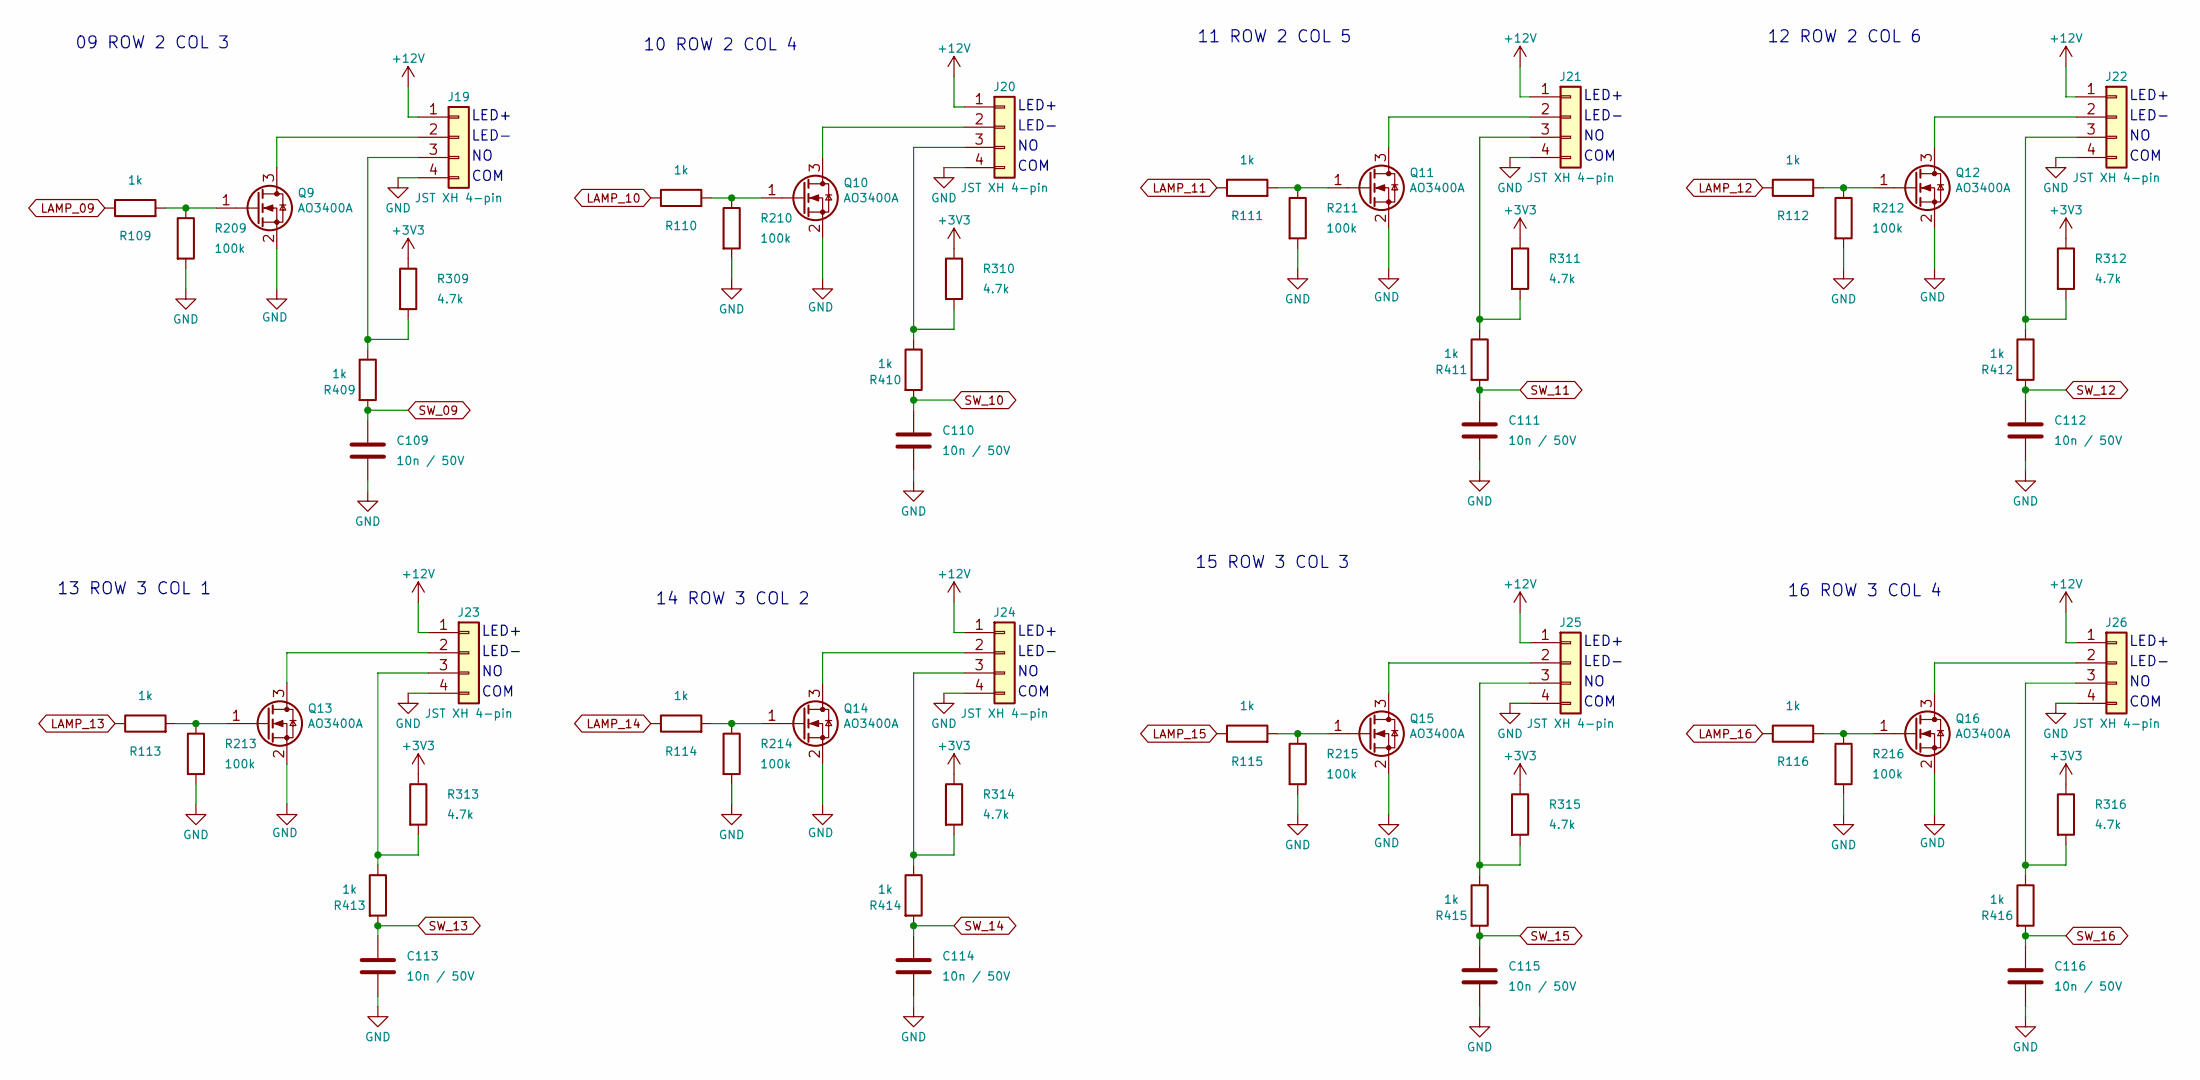
[picture p13: schematic button_bank_2.kicad_sch, Button harness: Buttons 09-16]

Parts:
C109, C110, C111, C112, C113, C114, C115, C116: 10n / 50V; C_1206_3216Metric_Pad1.33x1.80mm_HandSolder; MPN C1206C103K5RACTU; DigiKey 399-C1206C103K5RACTUCT-ND
J19, J20, J21, J22, J23, J24, J25, J26: JST XH 4-pin; JST_XH_B4B-XH-A_1x04_P2.50mm_Vertical; MPN B4B-XH-A; DigiKey 455-B4B-XH-A-ND
Q9, Q10, Q11, Q12, Q13, Q14, Q15, Q16: AO3400A; SOT-23; MPN AO3400A; DigiKey 785-1000-1-ND
R109, R110, R111, R112, R113, R114, R115, R116, R409, R410, R411, R412, R413, R414, R415, R416: 1k; R_1206_3216Metric_Pad1.30x1.75mm_HandSolder; MPN RC1206FR-071KL; DigiKey 311-1.00KFRCT-ND
R209, R210, R211, R212, R213, R214, R215, R216: 100k; R_1206_3216Metric_Pad1.30x1.75mm_HandSolder; MPN RC1206FR-07100KL; DigiKey 311-100KFRCT-ND
R309, R310, R311, R312, R313, R314, R315, R316: 4.7k; R_1206_3216Metric_Pad1.30x1.75mm_HandSolder; MPN RC1206FR-074K7L; DigiKey 311-4.70KFRCT-ND

Connections:
+3V3: R309.1, R310.1, R311.1, R312.1, R313.1, R314.1, R315.1, R316.1; also elsewhere on the board
+12V: J19.1, J20.1, J21.1, J22.1, J23.1, J24.1, J25.1, J26.1; also elsewhere on the board
GND: C109.2, C110.2, C111.2, C112.2, C113.2, C114.2, C115.2, C116.2, J19.4, J20.4, J21.4, J22.4, J23.4, J24.4, J25.4, J26.4, Q9.2 (S), Q10.2 (S), Q11.2 (S), Q12.2 (S), Q13.2 (S), Q14.2 (S), Q15.2 (S), Q16.2 (S), R209.2, R210.2, R211.2, R212.2, R213.2, R214.2, R215.2, R216.2; also elsewhere on the board
LAMP_09: R109.1; also elsewhere on the board
LAMP_10: R110.1; also elsewhere on the board
LAMP_11: R111.1; also elsewhere on the board
LAMP_12: R112.1; also elsewhere on the board
LAMP_13: R113.1; also elsewhere on the board
LAMP_14: R114.1; also elsewhere on the board
LAMP_15: R115.1; also elsewhere on the board
LAMP_16: R116.1; also elsewhere on the board
unnamed: J19.2, Q9.3 (D)
unnamed: J19.3, R309.2, R409.1
unnamed: J20.2, Q10.3 (D)
unnamed: J20.3, R310.2, R410.1
unnamed: J21.2, Q11.3 (D)
unnamed: J21.3, R311.2, R411.1
unnamed: J22.2, Q12.3 (D)
unnamed: J22.3, R312.2, R412.1
unnamed: J23.2, Q13.3 (D)
unnamed: J23.3, R313.2, R413.1
unnamed: J24.2, Q14.3 (D)
unnamed: J24.3, R314.2, R414.1
unnamed: J25.2, Q15.3 (D)
unnamed: J25.3, R315.2, R415.1
unnamed: J26.2, Q16.3 (D)
unnamed: J26.3, R316.2, R416.1
unnamed: Q9.1 (G), R109.2, R209.1
unnamed: Q10.1 (G), R110.2, R210.1
unnamed: Q11.1 (G), R111.2, R211.1
unnamed: Q12.1 (G), R112.2, R212.1
unnamed: Q13.1 (G), R113.2, R213.1
unnamed: Q14.1 (G), R114.2, R214.1
unnamed: Q15.1 (G), R115.2, R215.1
unnamed: Q16.1 (G), R116.2, R216.1
SW_09: C109.1, R409.2; also elsewhere on the board
SW_10: C110.1, R410.2; also elsewhere on the board
SW_11: C111.1, R411.2; also elsewhere on the board
SW_12: C112.1, R412.2; also elsewhere on the board
SW_13: C113.1, R413.2; also elsewhere on the board
SW_14: C114.1, R414.2; also elsewhere on the board
SW_15: C115.1, R415.2; also elsewhere on the board
SW_16: C116.1, R416.2; also elsewhere on the board

Notes on the sheet:
15 ROW 3 COL 3
11 ROW 2 COL 5
13 ROW 3 COL 1
LED+
COM
LED-
10 ROW 2 COL 4
12 ROW 2 COL 6
16 ROW 3 COL 4
14 ROW 3 COL 2
09 ROW 2 COL 3

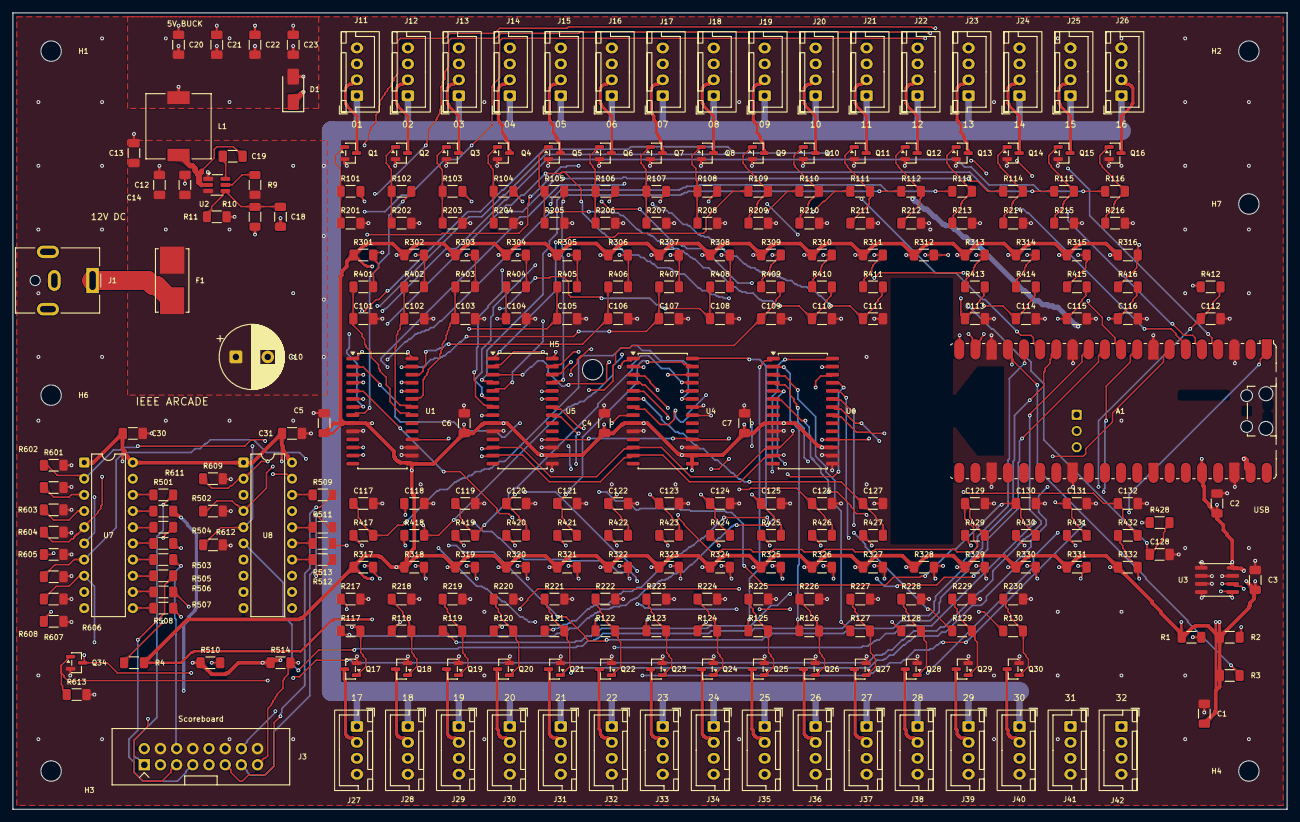
[picture p14: board IEEEArcade.kicad_pcb from above]

Board: 4 copper layers, 200.0 x 125.0 mm, 292 parts (0 on the bottom side), 206 nets.

Other parts of the board:
H1, H2, H3, H4, H5, H6, H7: M3 / 3.2mm NPTH; MountingHole_3.2mm_M3
