aakash3141/ieeewhackaclanker/(commit log)

2026-10-27 Kicad automatically fixed an error :)
    [IEEEArcade.kicad_sch]
2026-10-27 added two labels
    [IEEEArcade.kicad_sch, buck_converter.kicad_sch, eeprom.kicad_sch]
2026-10-27 Top 10 Buck Converters (Not Clickbait)
    [buck_converter.kicad_sch]
2026-10-27 Update o_expander
    [o_expander.kicad_sch]
2026-11-05 11/5 Morning
    [BOM-schematic.csv, IEEEArcade.kicad_sch, buck_converter.kicad_sch, buck_converter_max.kicad_sch, button_bank_1.kicad_sch, button_bank_2.kicad_sch, button_bank_3.kicad_sch, button_bank_4.kicad_sch]
2026-11-05 11/5 Afternoon
    [BOM-schematic.csv, IEEEArcade.kicad_sch, button_bank_1.kicad_sch, button_bank_2.kicad_sch, button_bank_3.kicad_sch, button_bank_4.kicad_sch, external_buttons_1.kicad_sch, external_buttons_2.kicad_sch]
2026-11-05 11/5 evening
    [IEEEArcade.kicad_pcb, IEEEArcade.kicad_sch, before-netname-test.kicad_pcb, button_bank_1.kicad_sch, button_bank_2.kicad_sch, button_bank_3.kicad_sch, button_bank_4.kicad_sch, external_buttons_1.kicad_sch]
2026-11-10 11/10 Pre meeting
    [26-27 Project BOM.xlsx, BOM-schematic.csv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]
2026-11-11 11/10 during meeting
    [DigiKey-board-cart.csv, DigiKey-board-details.csv, DigiKey-optional-harness.csv, scoreboard.kicad_sch]
2026-11-13 Clean-up 11/13
    [26-27 Project BOM.xlsx, BOM-schematic.csv, DigiKey-board-cart.csv, DigiKey-board-details.csv, DigiKey-optional-harness.csv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]
